SergiiPolokhalo/ZX-UNO_Pi/w25q128_sreg.png

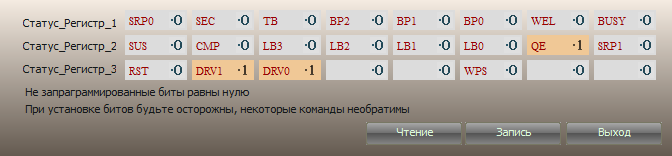
w25q128_sreg.png
