SergiiPolokhalo/ZX-UNO_Pi/README.md

# ZX-UNO_Pi
 Clone ZX-UNO for Raspberry PI Case
