SergiiPolokhalo/ZX-UNO_Pi/Shematic/joy.png

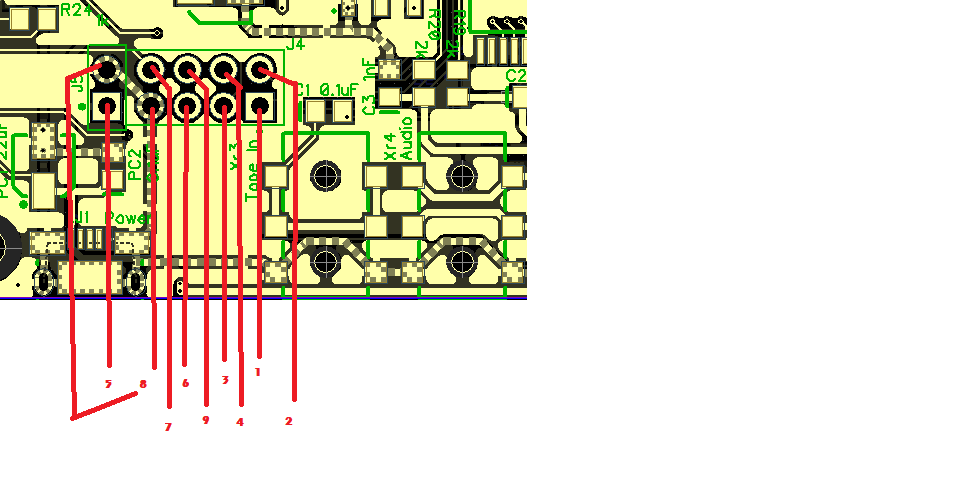
Shematic/joy.png
