SergiiPolokhalo/ZX-UNO_Pi/case/models/unopi-top.stl

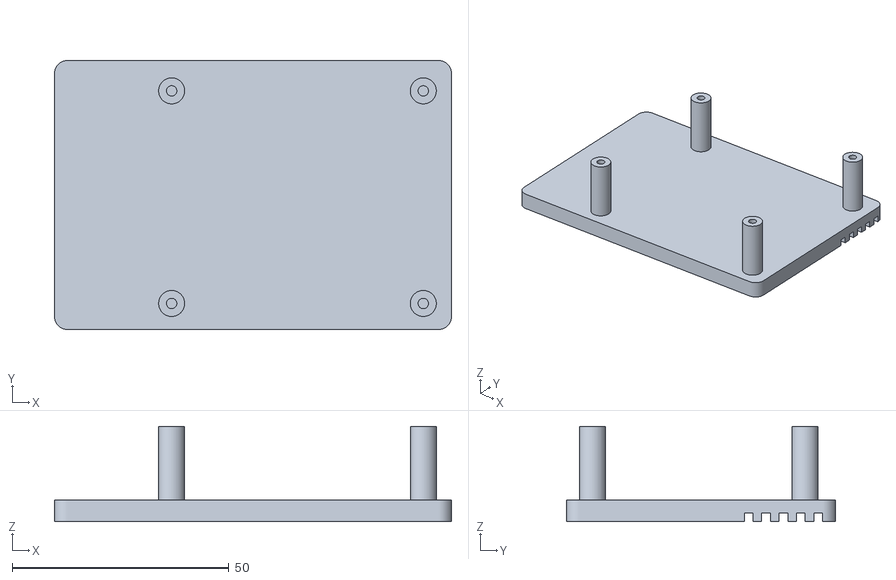
[picture p3: CAD file, 2021-05-10]
case/models/unopi-top.stl
91.5 x 62.0 x 22.0
