SergiiPolokhalo/ZX-UNO_Pi/case/models/unopi-bottom.stl

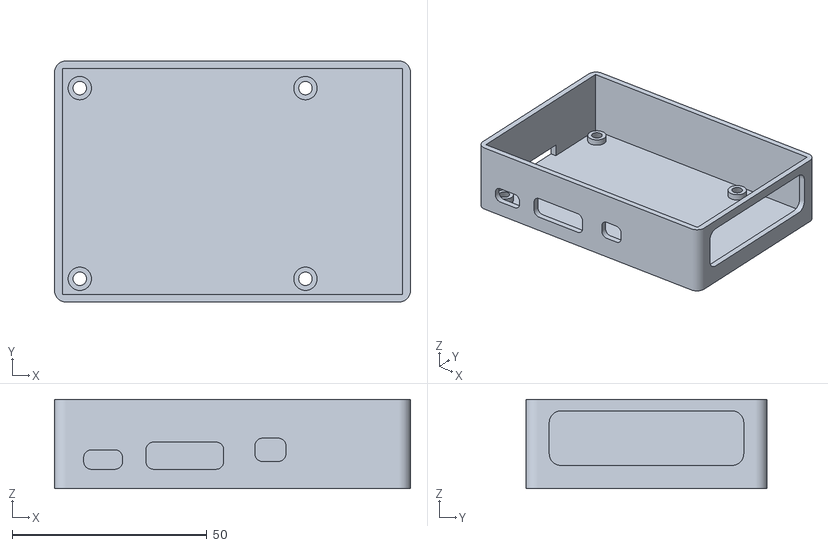
[picture p4: CAD file, 2021-05-10]
case/models/unopi-bottom.stl
91.5 x 62.0 x 23.0
