SergiiPolokhalo/ZX-UNO_Pi/Shematic/UNO_PI_SHEMATIC.pdf

# Xr1 Xr2

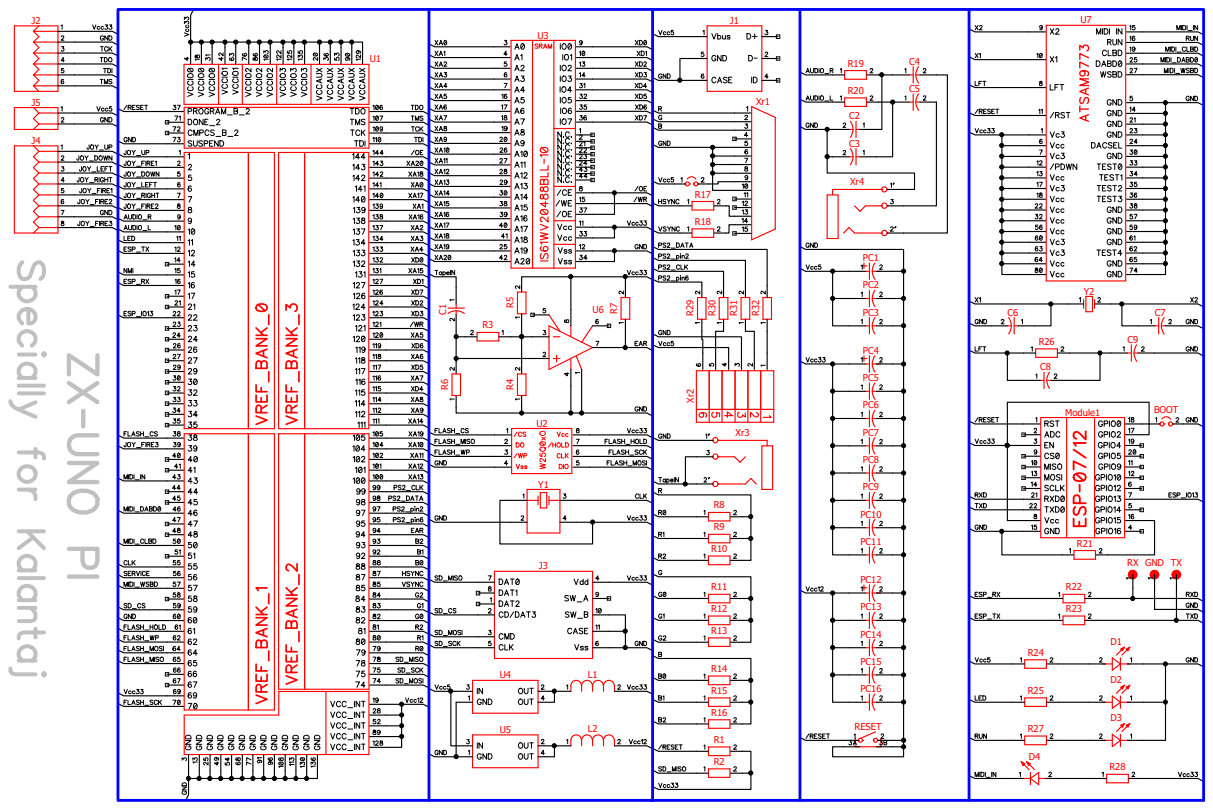
[picture p5: page 1]
