SergiiPolokhalo/ZX-UNO_Pi/Shematic/uno_pi_fix.pdf

Фикс помех WiFi & MicroSD на канал звука (в новой ревизии исправленно )

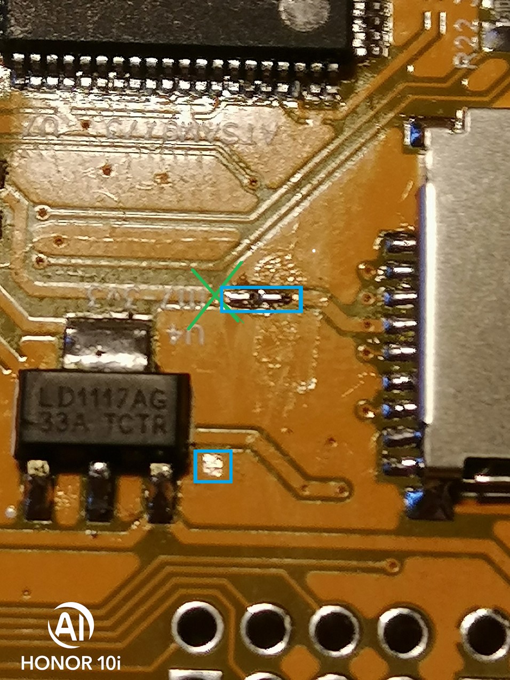
[picture p6: figure]

Разрезать дорожку возле цифры «1» зачистить в обведенных местах

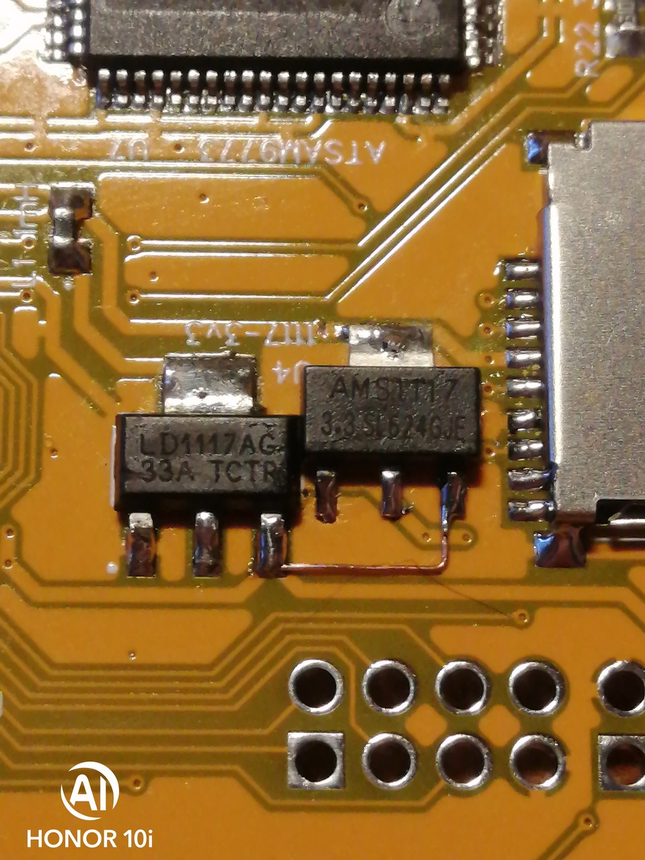
[picture p7: figure]

Припаять на зачищенные места 1117-3.3 соединить 3е ножки U4 и дополнительного стабилизатора
